Daxxn/EasyBakeOven/Docs/Pinouts/EasyBakeREV1Pinout.md

# EasyBakeREV1

> > Micro: **PRO-MICRO**
>
> > Digital Pins: **16**
> >
> > Analog Pins: **4**
>
> > Comms:
> > - SPI
> > - I2C
> > - UART

---

## Digital

### Oven
Pin Count: 3

| Pin | Name | Type
| --- | --- | --- |
| 6 | HTR_PWM | PWM |
| 4 | HTR_SW | IN |
| 2 | ESTOP | IN |

### Sensing
Pin Count: 1

| Pin | Name | Type
| --- | --- | --- |
| 6 | SW | IN |

### Indictors
Pin Count: 5

| Pin | Name | Type
| --- | --- | --- |
| 11 | COOL | PWM |
| 12 | STATUS | PWM |
| 36 | ERROR | OUT |
| 37 | ACT | OUT |
| 38 | HEAT | OUT |

### Display
Pin Count: 2

| Pin | Name | Type
| --- | --- | --- |
| 9 | BACKLIGHT | PWM |
| 13 | RESET | OUT |

## Analog

### Sensing
Pin Count: 2

| Pin | Name | Type
| --- | --- | --- |
| 4 | APEAK | IN |
| 5 | ACURRENT | IN |

## Serial

### SPI

### Pins

| Name | Pin |
| --- | --- |
| SCK | 15 |
| MISO | 14 |
| MOSI | 16 |

### Addresses

| Name | Pin |
| --- | --- |
| Display | 5 |
| IO | 4 |

### I2C

### Pins

| Name | Pin |
| --- | --- |
| SDA | 2 |
| SCL | 3 |

### UART

### Pins

| Name | Pin |
| --- | --- |
| TX | 1 |
| RX | 0 |

> Auto-generated by [PinGenerator app.](https://github.com/Daxxn/PinGenerator)
>
> Author: Daxxn
