Daxxn/EasyBakeOven/EasyBakeREV1/EasyBakePower.md

# Power Analysis

## 3.3V Rail Loads

| Ref | Device| Name | Current |
| --- | --- | --- | --- |
| A1 | ATMEGA32U4 | Arduino PRO-MICRO | 10mA |
| U5 | NHD-C12832A1Z | LCD Screen | 31mA |
| D-ACT | 0805-LED | LED - Activity Indicator | 15mA |
| D-ERR | 0805-LED | LED - Error Indicator | 15mA |
| D-HEAT | 0805-LED | LED - Heat Indicator | 15mA |
| D-COOL | 0805-LED | LED - Cool Indicator | 15mA |
| D-STA | 0805-LED | LED - Status Indicator | 15mA |
| D-PWR | 0805-LED | LED - Power Indicator | 15mA |
| D-USB | 0805-LED | LED - USB Status Indicator | 15mA |
| U7 | MAX31855 | Thermo Amp | 1.5mA |
| U8 | LMV324 | Current Amp | 1.2mA |
| SW-RST | TL3365 | Reset Switch | 330uA |
| SW-M-UP | TL3365 | Menu Up Switch | 330uA |
| SW-M-DN | TL3365 | Menu Down Switch | 330uA |
| SW-M-L | TL3365 | Menu Left Switch | 330uA |
| SW-M-R | TL3365 | Menu Right Switch | 330uA |
| SW-M-SEL | TL3365 | Menu Select Switch | 330uA |
| SW-M-BK | TL3365 | Menu Back Switch | 330uA |

### 3.3V Rail Total Load : 151mA
