Daxxn/EasyBakeOven/Docs/Schematics/EasyBake-REV1-SCH.pdf

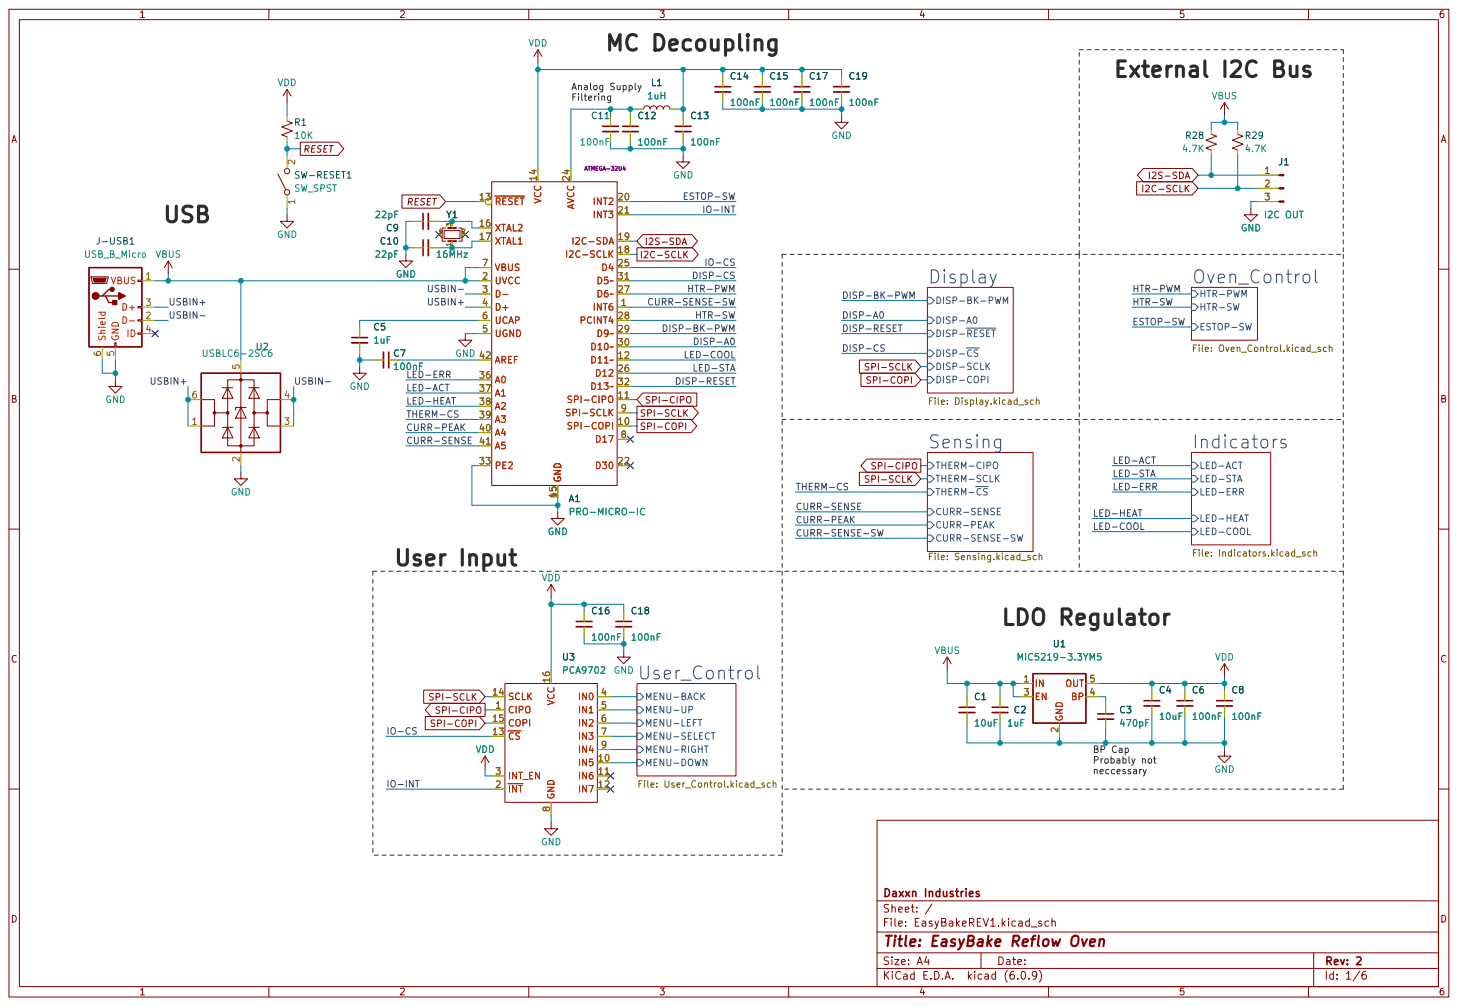
[picture p1: page 1]

IO-INT ESTOP-SW

File: Indicators.kicad_sch DISP-SCLK DISP-A0 DISP-~{CS} DISP-COPI DISP-~{RESET} DISP-BK-PWM Display

ESTOP-SW Oven_Control File: Oven_Control.kicad_sch CURR-PEAK

100nF GND

THERM-~{CS} CURR-SENSE CURR-SENSE-SW Sensing

Probably not neccessary User Input

File: EasyBakeREV1.kicad_sch Sheet: / Daxxn Industries MENU-BACK MENU-LEFT MENU-SELECT MENU-UP MENU-DOWN MENU-RIGHT User_Control File: User_Control.kicad_sch

SPI-COPI SPI-SCLK
SPI-CIPO

Id: 1/6 Title: EasyBake Reflow Oven

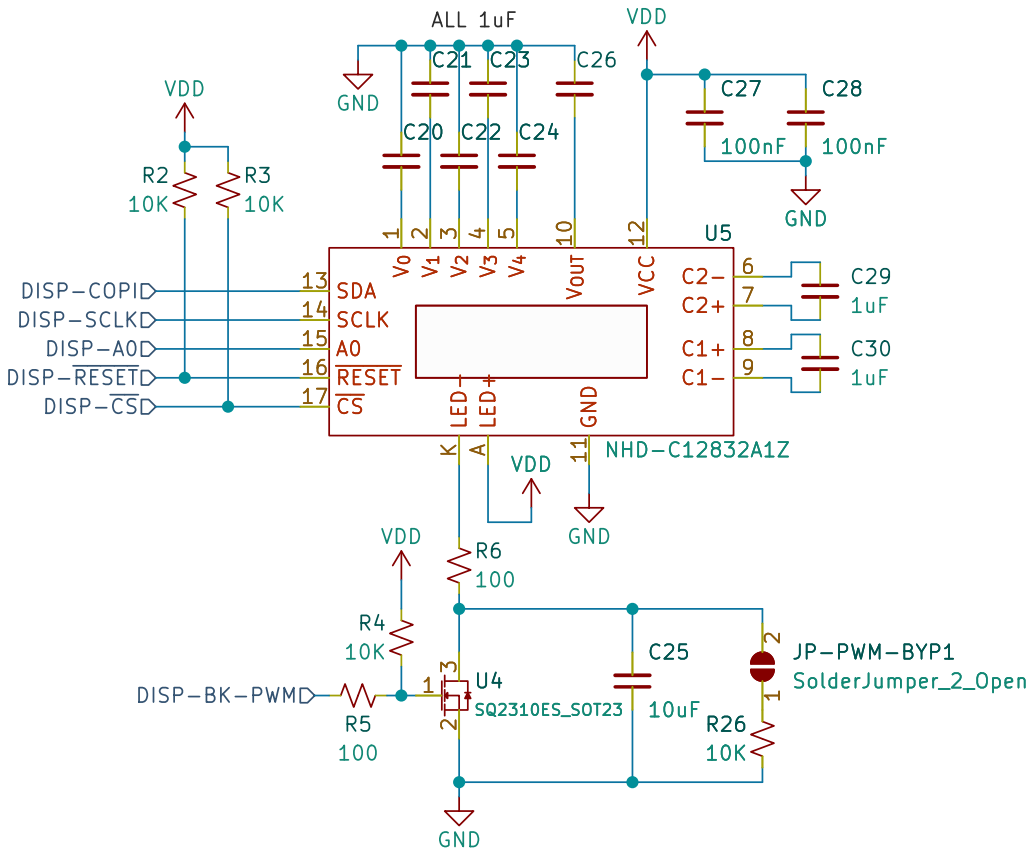
[picture p2: page 2]

10K DISP-COPI DISP-A0 DISP-~{RESET} DISP-BK-PWM

Sheet: /Display/ Daxxn Industries

File: Display.kicad_sch
Id: 2/6 Title: EasyBake Reflow Oven

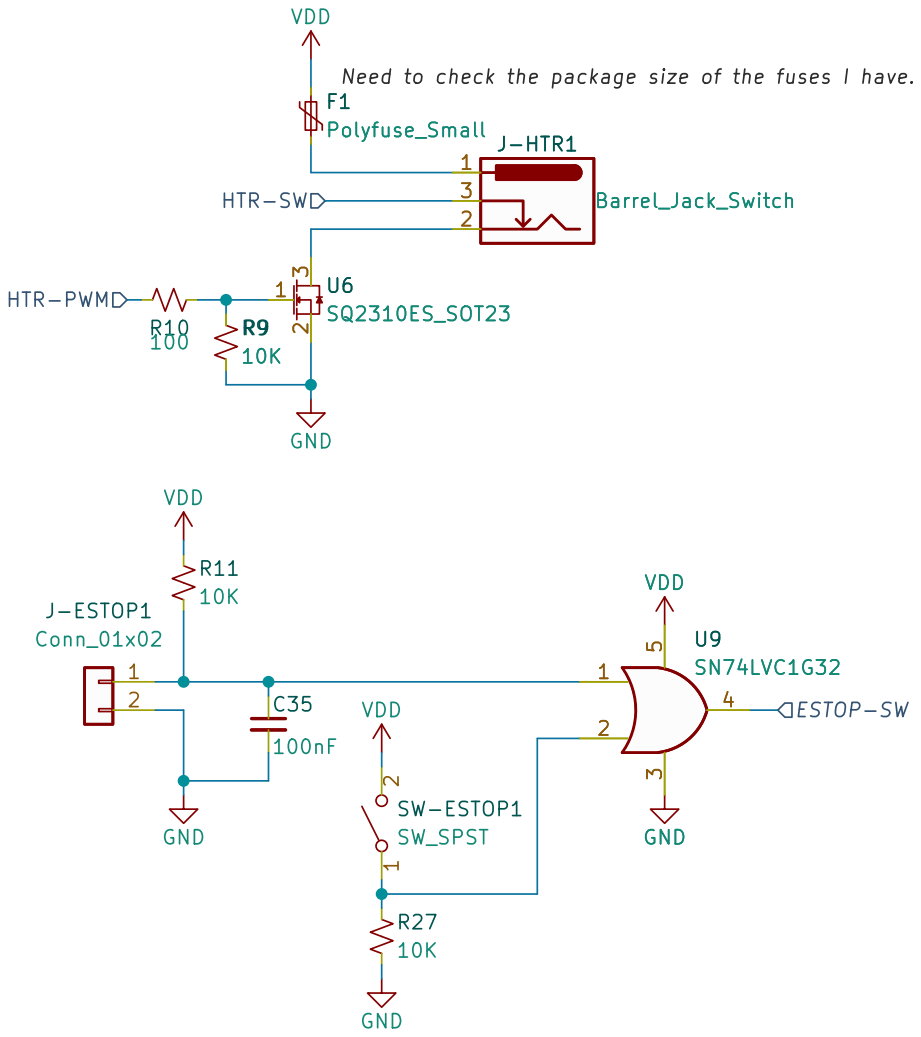
[picture p3: page 3]

Need to check the package size of the fuses I have. R9
10K GND GND

File: Oven_Control.kicad_sch
Id: 3/6 Title: EasyBake Reflow Oven

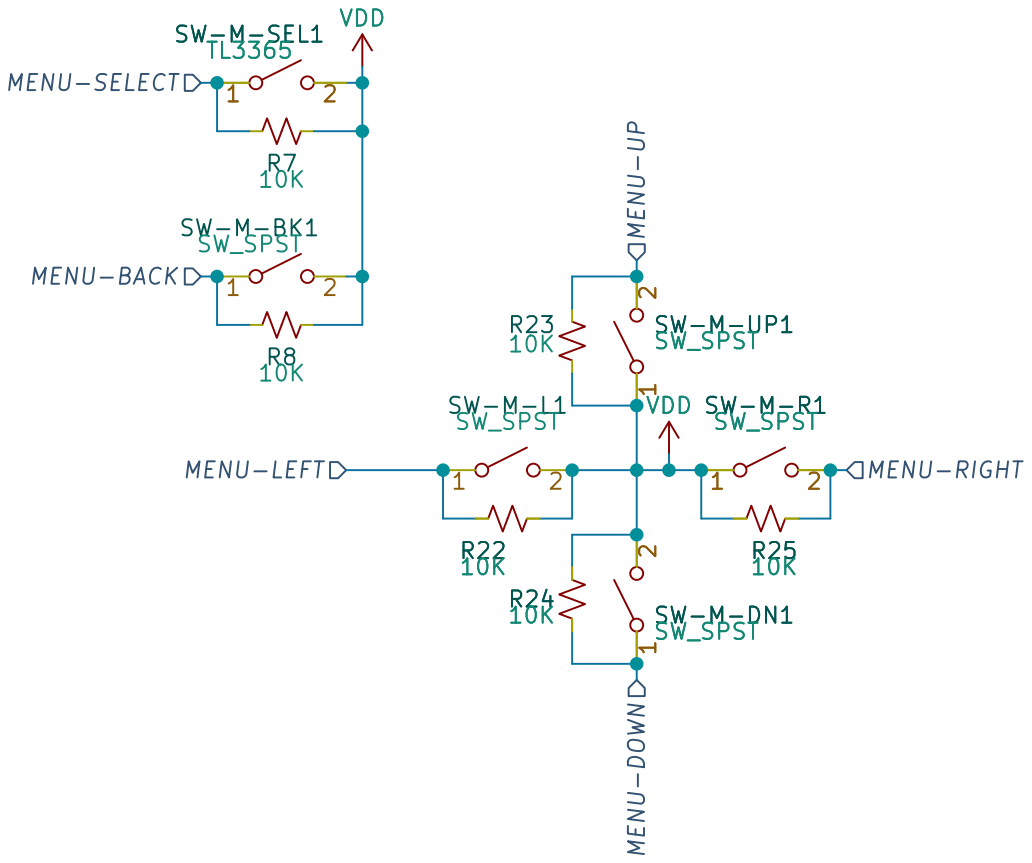
[picture p4: page 4]

1 2 SW-M-DN1 SW_SPST MENU-UP MENU-BACK MENU-LEFT MENU-SELECT MENU-RIGHT MENU-DOWN VDD

File: User_Control.kicad_sch
Id: 4/6 Title: EasyBake Reflow Oven

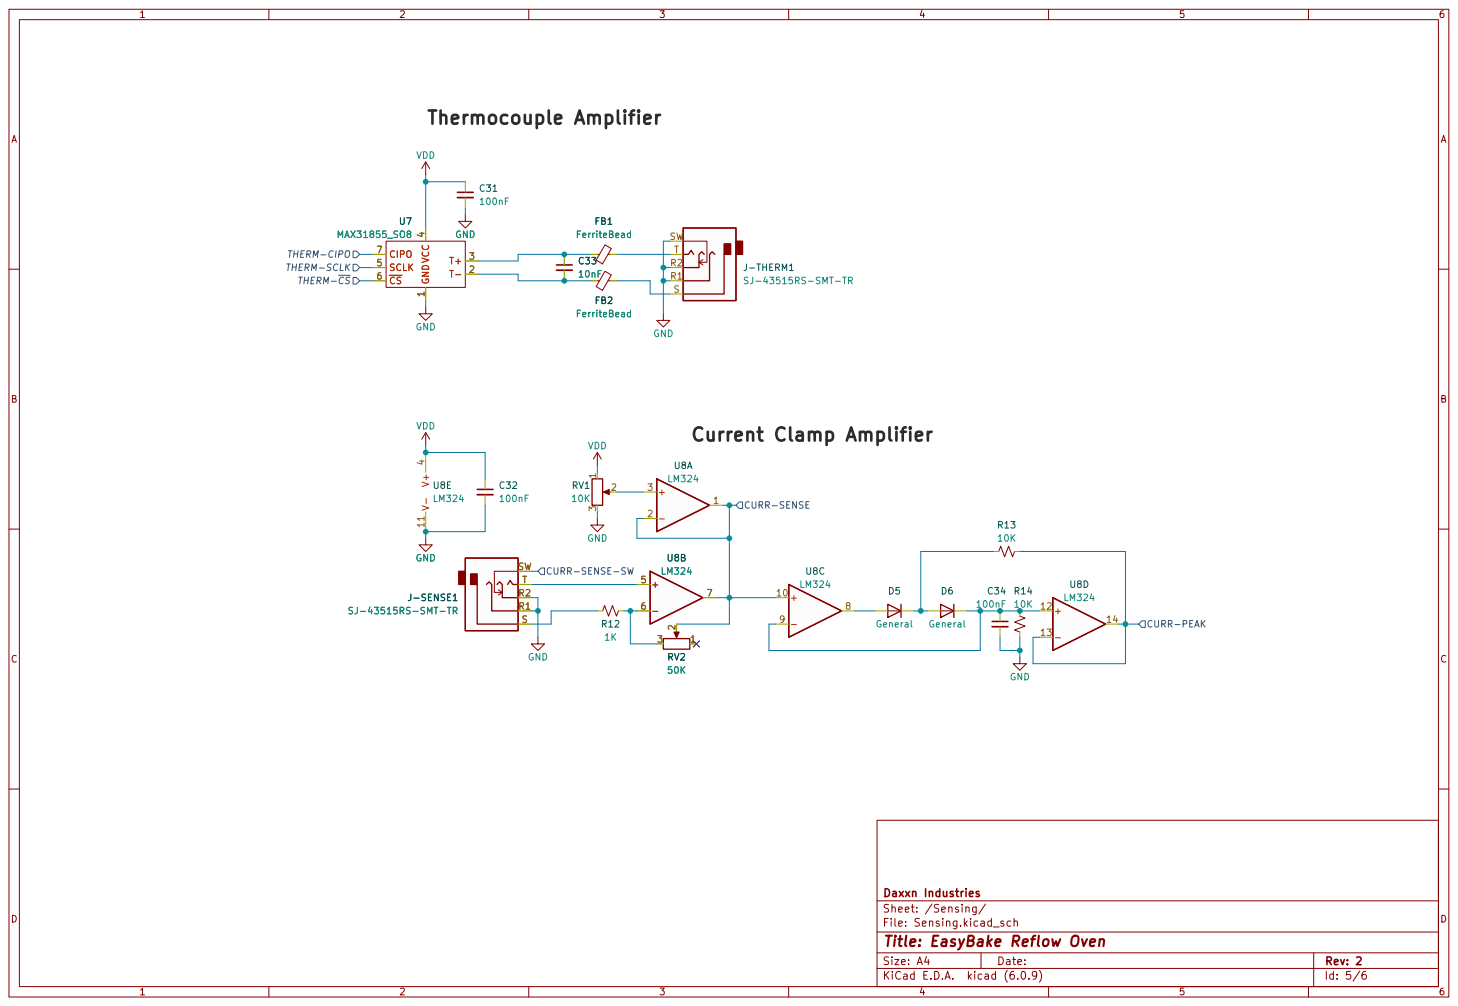
[picture p5: page 5]

CURR-SENSE Thermocouple Amplifier

4 SCLK 5 ~{CS} 6 CIPO 7 U7 MAX31855_SO8 VDD

File: Sensing.kicad_sch
Id: 5/6 Title: EasyBake Reflow Oven

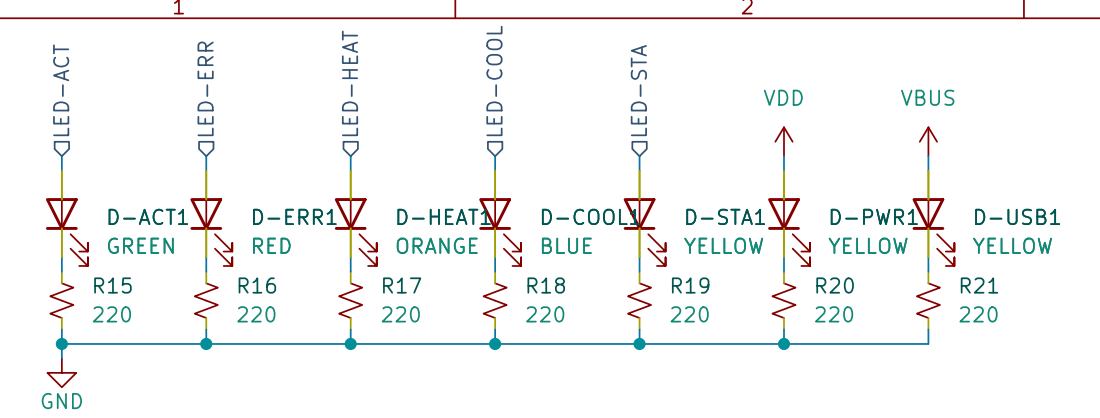
[picture p6: page 6]

File: Indicators.kicad_sch Sheet: /Indicators/
Id: 6/6 Title:
