Daxxn/EasyBakeOven/EasyBakeREV1/EasyBakeREV1.kicad_pcb

## KiCad design EasyBakeREV1/EasyBakeREV1.kicad_pcb (2023-03-19)

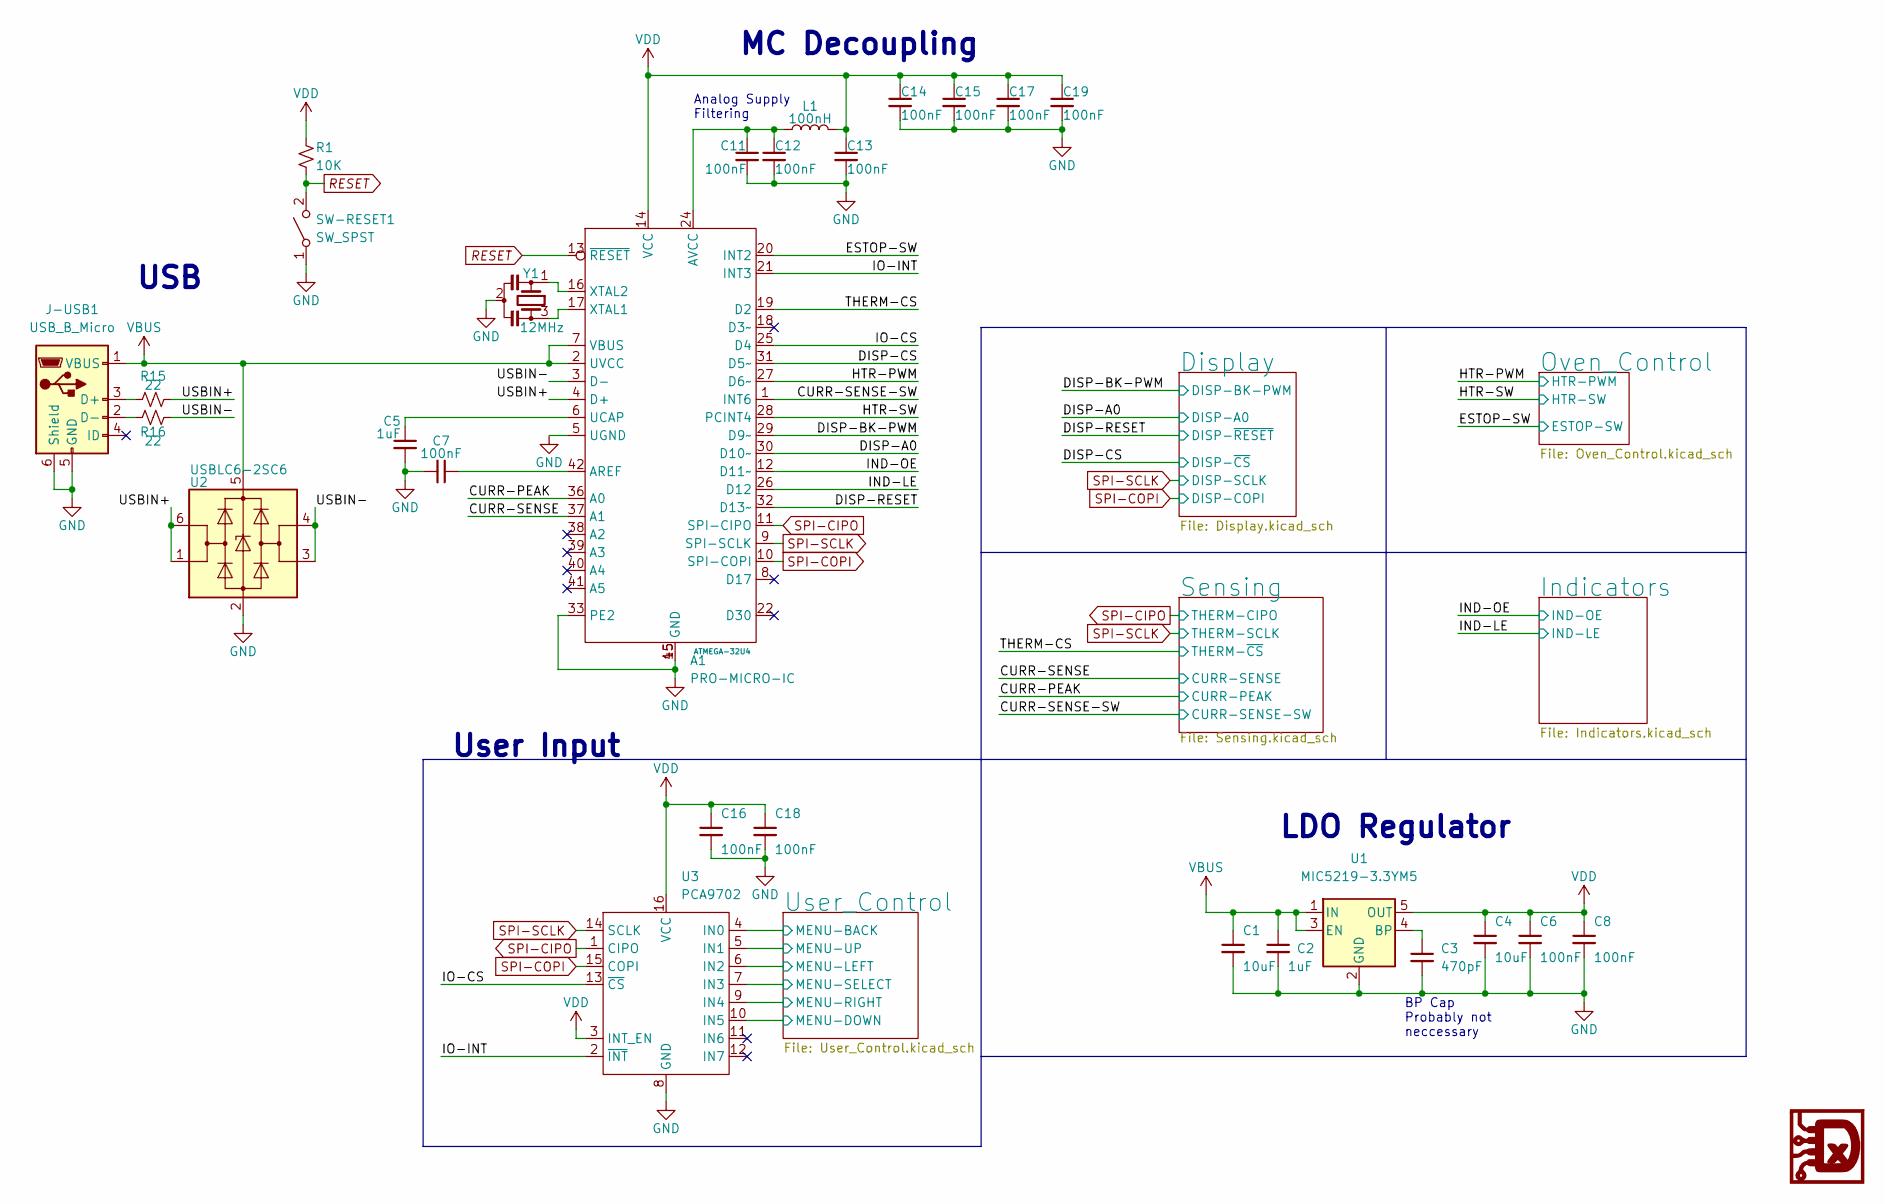
[picture p7: schematic EasyBakeREV1.kicad_sch, EasyBake Reflow Oven]

Parts:
A1: PRO-MICRO-IC; QFN-44-1EP_7x7mm_P0.5mm_EP4.8x4.8mm
C1, C4: 10uF; C_1210_3225Metric
C2: 1uF; C_1210_3225Metric
C3: 470pF; C_0603_1608Metric
C5: 1uF; C_0805_2012Metric
C6, C7, C8, C11, C12, C13, C14, C15, C16, C17, C18, C19: 100nF; C_0603_1608Metric
J-USB1: USB_B_Micro; USB-10103594
L1: 100nH; L_0603_1608Metric
R1: 10K; R_0603_1608Metric
R15, R16: 22; R_0402_1005Metric
SW-RESET1: SW_SPST; TL3365AF180QG
U1: MIC5219-3.3YM5; SOT-23-5
U2: USBLC6-2SC6; SOT-23-6
U3: PCA9702; SSOP-16_4.4x5.2mm_P0.65mm
Y1: 12MHz; Resonator_SMD_Murata_CSTxExxV-3Pin_3.0x1.1mm

Connections:
/CURR-PEAK: A1.36 (A0); also elsewhere on the board
/CURR-SENSE: A1.37 (A1); also elsewhere on the board
/CURR-SENSE-SW: A1.1 (INT6); also elsewhere on the board
/DISP-A0: A1.30 (D10~); also elsewhere on the board
/DISP-BK-PWM: A1.29 (D9~); also elsewhere on the board
/DISP-CS: A1.31 (D5~); also elsewhere on the board
/DISP-RESET: A1.32 (D13~); also elsewhere on the board
/ESTOP-SW: A1.20 (INT2); also elsewhere on the board
/HTR-PWM: A1.27 (D6~); also elsewhere on the board
/HTR-SW: A1.28 (PCINT4); also elsewhere on the board
/IND-LE: A1.26 (D12); also elsewhere on the board
/IND-OE: A1.12 (D11~); also elsewhere on the board
/IO-CS: A1.25 (D4), U3.13 (~CS)
/IO-INT: A1.21 (INT3), U3.2 (~INT)
/THERM-CS: A1.19 (D2); also elsewhere on the board
/USBIN+: A1.4 (D+), R15.2, U2.1 (I/O1), U2.6 (I/O1)
/USBIN-: A1.3 (D-), R16.2, U2.3 (I/O2), U2.4 (I/O2)
/User_Control/MENU-BACK: U3.4 (IN0); also elsewhere on the board
/User_Control/MENU-DOWN: U3.10 (IN5); also elsewhere on the board
/User_Control/MENU-LEFT: U3.6 (IN2); also elsewhere on the board
/User_Control/MENU-RIGHT: U3.9 (IN4); also elsewhere on the board
/User_Control/MENU-SELECT: U3.7 (IN3); also elsewhere on the board
/User_Control/MENU-UP: U3.5 (IN1); also elsewhere on the board
AVCC: A1.24 (AVCC), A1.44 (AVCC), C11.1, C12.1, L1.1
GND: A1.5 (UGND), A1.15 (GND), A1.23 (GND), A1.33 (PE2), A1.35 (GND), A1.43 (GND), A1.45 (GND), C1.2, C2.2, C3.2, C4.2, C5.2, C6.2, C7.2, C8.2, C11.2, C12.2, C13.2, C14.2, C15.2, C16.2, C17.2, C18.2, C19.2, J-USB1.5 (GND), J-USB1.6 (Shield), SW-RESET1.1 (A), U1.2 (GND), U2.2 (GND), U3.8 (GND), Y1.2; also elsewhere on the board
unnamed: A1.6 (UCAP), C5.1
unnamed: A1.16 (XTAL2), Y1.1
unnamed: A1.17 (XTAL1), Y1.3
unnamed: A1.42 (AREF), C7.1
unnamed: C3.1, U1.4 (BP)
unnamed: J-USB1.2 (D-), R16.1
unnamed: J-USB1.3 (D+), R15.1
RESET: A1.13 (~RESET), R1.2, SW-RESET1.2 (B)
SPI-CIPO: A1.11 (SPI-CIPO), U3.1 (CIPO); also elsewhere on the board
SPI-COPI: A1.10 (SPI-COPI), U3.15 (COPI); also elsewhere on the board
SPI-SCLK: A1.9 (SPI-SCLK), U3.14 (SCLK); also elsewhere on the board
VBUS: A1.2 (UVCC), A1.7 (VBUS), C1.1, C2.1, J-USB1.1 (VBUS), U1.1 (IN), U1.3 (EN), U2.5 (VBUS); also elsewhere on the board
VCC: A1.14 (VCC), A1.34 (VCC), C4.1, C6.1, C8.1, C13.1, C14.1, C15.1, C16.1, C17.1, C18.1, C19.1, L1.2, R1.1, U1.5 (OUT), U3.3 (INT_EN), U3.16 (VCC); also elsewhere on the board

Notes on the sheet:
LDO Regulator
Analog Supply Filtering
MC Decoupling
User Input
USB
BP Cap Probably not neccessary

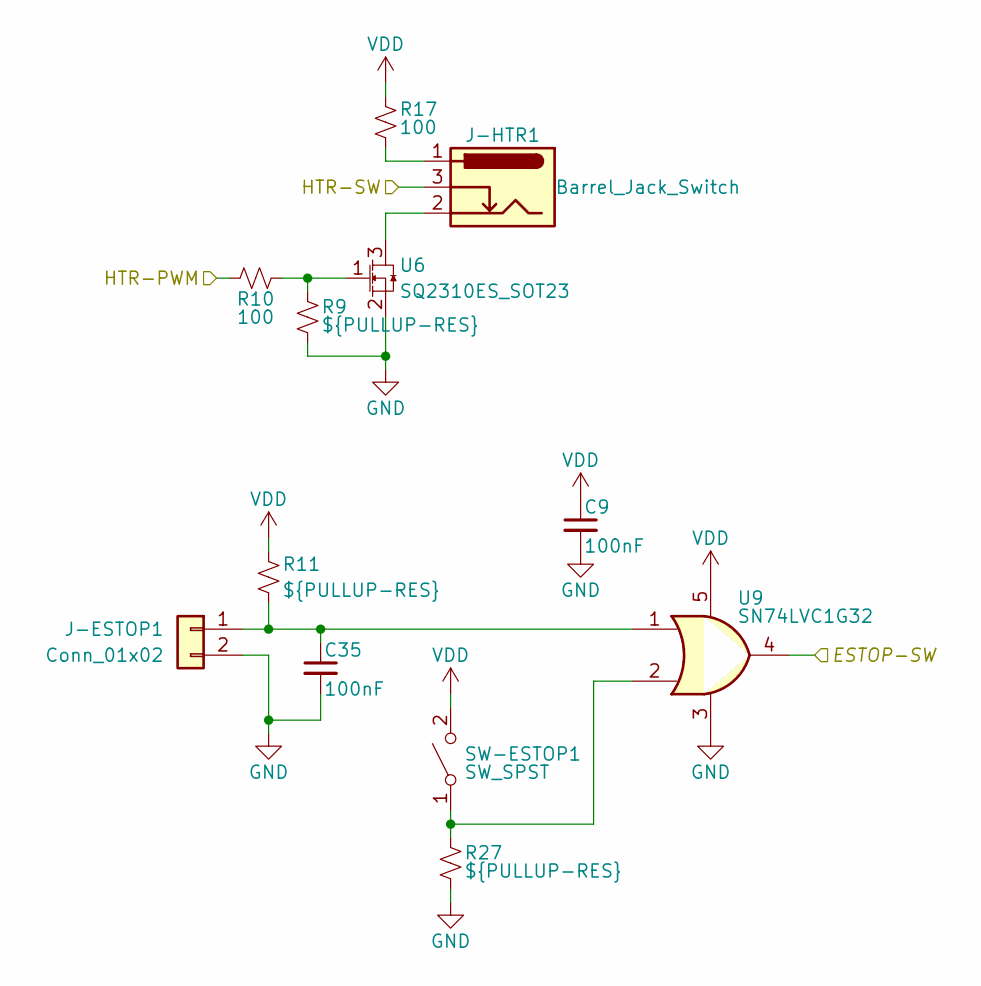
[picture p8: schematic Oven_Control.kicad_sch, EasyBake Reflow Oven]

Parts:
C9, C35: 100nF; C_0603_1608Metric
J-ESTOP1: Conn_01x02; JST_XH_B2B-XH-A_1x02_P2.50mm_Vertical
J-HTR1: Barrel_Jack_Switch; BarrelJack_Horizontal
R9, R11, R27: ${PULLUP-RES}; R_0603_1608Metric
R10, R17: 100; R_0603_1608Metric
SW-ESTOP1: SW_SPST; SW_PUSH_6mm_H8mm
U6: SQ2310ES_SOT23; SOT-23
U9: SN74LVC1G32; SOT-23-5

Connections:
/ESTOP-SW: U9.4; also elsewhere on the board
/HTR-PWM: R10.1; also elsewhere on the board
/HTR-SW: J-HTR1.3; also elsewhere on the board
GND: C9.2, C35.2, J-ESTOP1.2, R9.2, R27.1, U6.2 (S), U9.3; also elsewhere on the board
unnamed: C35.1, J-ESTOP1.1, R11.1, U9.1
unnamed: J-HTR1.1, R17.1
unnamed: J-HTR1.2, U6.3 (D)
unnamed: R9.1, R10.2, U6.1 (G)
unnamed: R27.2, SW-ESTOP1.1 (A), U9.2
VCC: C9.1, R11.2, R17.2, SW-ESTOP1.2 (B), U9.5; also elsewhere on the board

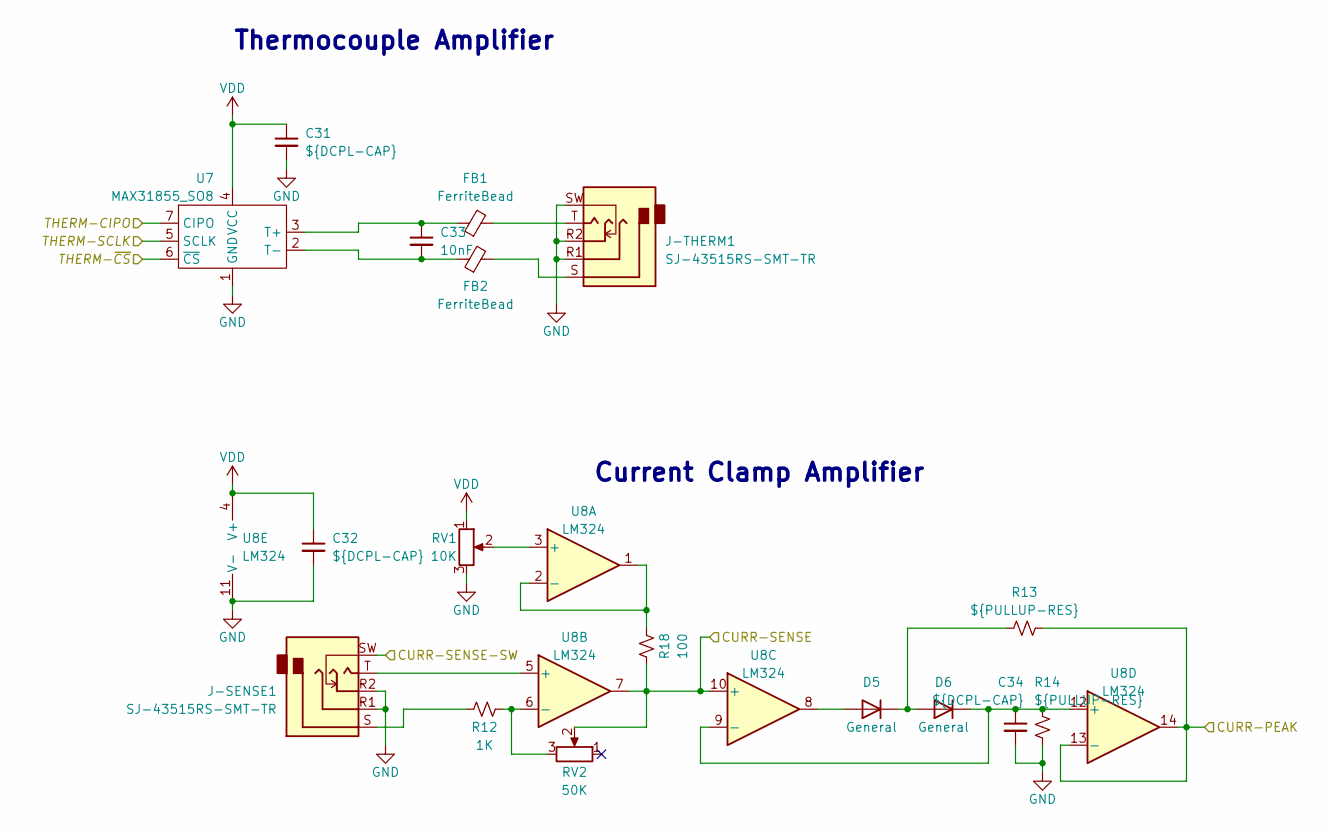
[picture p9: schematic Sensing.kicad_sch, EasyBake Reflow Oven]

Parts:
C31, C32, C34: ${DCPL-CAP}; C_0603_1608Metric
C33: 10nF; C_0603_1608Metric
D5, D6: General; D_SOD-323_HandSoldering
FB1, FB2: FerriteBead; L_1206_3216Metric
J-SENSE1: SJ-43515RS-SMT-TR
J-THERM1: SJ-43515RS-SMT-TR
R12: 1K; R_0603_1608Metric
R13, R14: ${PULLUP-RES}; R_0603_1608Metric
R18: 100; R_0603_1608Metric
RV1: 10K; Potentiometer_Bourns_3296W_Vertical
RV2: 50K; Potentiometer_Bourns_3296W_Vertical
U7: MAX31855_SO8; SO-8_3.9x4.9mm_P1.27mm
U8: LM324; TSSOP-14_4.4x5mm_P0.65mm

Connections:
/CURR-PEAK: R13.2, U8.13 (-), U8.14; also elsewhere on the board
/CURR-SENSE: R18.1, RV2.2, U8.7, U8.10 (+); also elsewhere on the board
/CURR-SENSE-SW: J-SENSE1.SW; also elsewhere on the board
/THERM-CS: U7.6 (~CS); also elsewhere on the board
GND: C31.2, C32.2, C34.2, J-SENSE1.R1, J-SENSE1.R2, J-THERM1.R1, J-THERM1.R2, J-THERM1.SW, R14.1, RV1.3, U7.1 (GND), U8.11 (V-); also elsewhere on the board
unnamed: C33.1, FB1.1, U7.3 (T+)
unnamed: C33.2, FB2.1, U7.2 (T-)
unnamed: C34.1, D6.1 (K), R14.2, U8.9 (-), U8.12 (+)
unnamed: D5.1 (K), D6.2 (A), R13.1
unnamed: D5.2 (A), U8.8
unnamed: FB1.2, J-THERM1.T
unnamed: FB2.2, J-THERM1.S
unnamed: J-SENSE1.S, R12.1
unnamed: J-SENSE1.T, U8.5 (+)
unnamed: R12.2, RV2.3, U8.6 (-)
unnamed: R18.2, U8.1, U8.2 (-)
unnamed: RV1.2, U8.3 (+)
SPI-CIPO: U7.7 (CIPO); also elsewhere on the board
SPI-SCLK: U7.5 (SCLK); also elsewhere on the board
VCC: C31.1, C32.1, RV1.1, U7.4 (VCC), U8.4 (V+); also elsewhere on the board

Notes on the sheet:
Thermocouple Amplifier
Current Clamp Amplifier

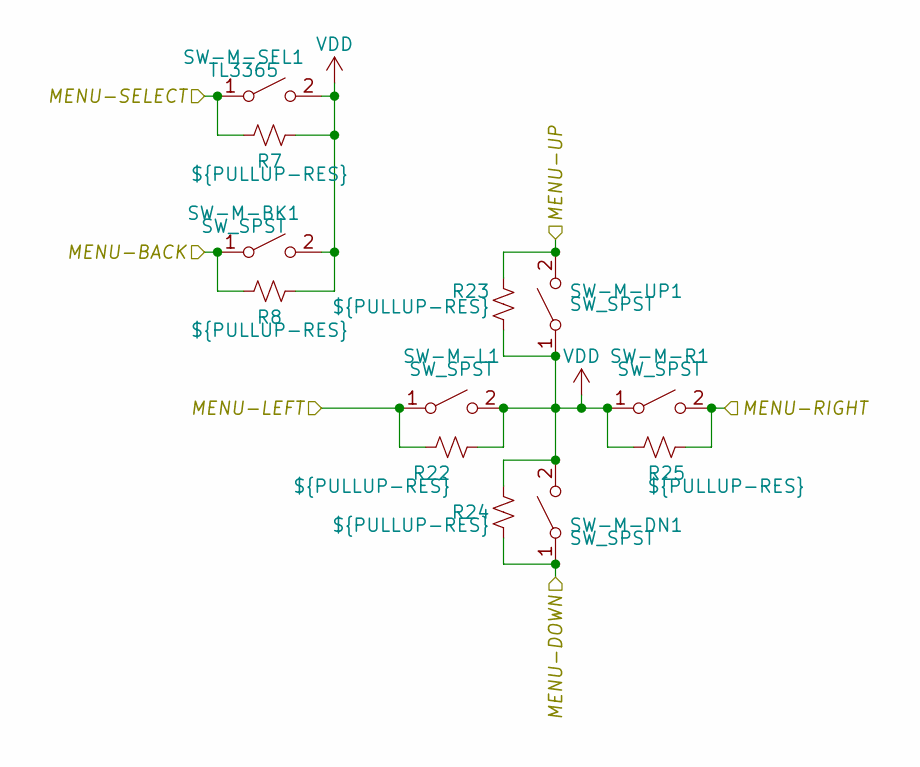
[picture p10: schematic User_Control.kicad_sch, EasyBake Reflow Oven]

Parts:
R7, R8, R22, R23, R24, R25: ${PULLUP-RES}; R_0805_2012Metric
SW-M-BK1: SW_SPST; TL3365AF180QG
SW-M-DN1: SW_SPST; TL3365AF180QG
SW-M-L1: SW_SPST; TL3365AF180QG
SW-M-R1: SW_SPST; TL3365AF180QG
SW-M-SEL1: TL3365; TL3365AF180QG
SW-M-UP1: SW_SPST; TL3365AF180QG

Connections:
/User_Control/MENU-BACK: R8.1, SW-M-BK1.1 (A); also elsewhere on the board
/User_Control/MENU-DOWN: R24.2, SW-M-DN1.1 (A); also elsewhere on the board
/User_Control/MENU-LEFT: R22.1, SW-M-L1.1 (A); also elsewhere on the board
/User_Control/MENU-RIGHT: R25.2, SW-M-R1.2 (B); also elsewhere on the board
/User_Control/MENU-SELECT: R7.1, SW-M-SEL1.1 (A); also elsewhere on the board
/User_Control/MENU-UP: R23.1, SW-M-UP1.2 (B); also elsewhere on the board
VCC: R7.2, R8.2, R22.2, R23.2, R24.1, R25.1, SW-M-BK1.2 (B), SW-M-DN1.2 (B), SW-M-L1.2 (B), SW-M-R1.1 (A), SW-M-SEL1.2 (B), SW-M-UP1.1 (A); also elsewhere on the board

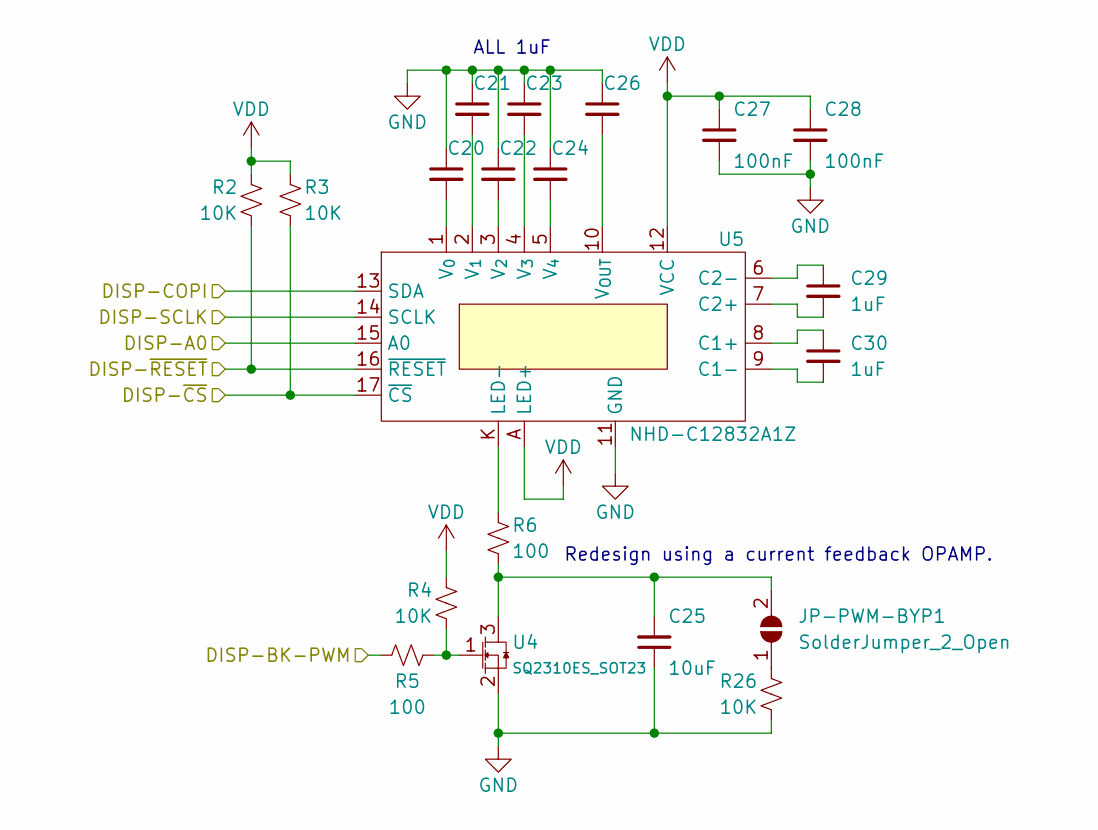
[picture p11: schematic Display.kicad_sch, EasyBake Reflow Oven]

Parts:
C20, C21, C22, C23, C24, C26, C29, C30: 1uF; C_1210_3225Metric
C25: 10uF; C_0805_2012Metric
C27, C28: 100nF; C_0805_2012Metric
JP-PWM-BYP1: SolderJumper_2_Open; SolderJumper-2_P1.3mm_Open_TrianglePad1.0x1.5mm
R2, R3, R4, R26: 10K; R_0603_1608Metric
R5, R6: 100; R_0603_1608Metric
U4: SQ2310ES_SOT23; SOT-23
U5: NHD-C12832A1Z

Connections:
/DISP-A0: U5.15 (A0); also elsewhere on the board
/DISP-BK-PWM: R5.2; also elsewhere on the board
/DISP-CS: R3.2, U5.17 (~CS); also elsewhere on the board
/DISP-RESET: R2.2, U5.16 (~RESET); also elsewhere on the board
GND: C20.1, C21.1, C22.1, C23.1, C24.1, C25.1, C26.1, C27.2, C28.2, R26.2, U4.2 (S), U5.11 (GND); also elsewhere on the board
unnamed: C20.2, U5.1 (V_{0})
unnamed: C21.2, U5.2 (V_{1})
unnamed: C22.2, U5.3 (V_{2})
unnamed: C23.2, U5.4 (V_{3})
unnamed: C24.2, U5.5 (V_{4})
unnamed: C25.2, JP-PWM-BYP1.2 (B), R6.2, U4.3 (D)
unnamed: C26.2, U5.10 (V_{OUT})
unnamed: C29.1, U5.6 (C2-)
unnamed: C29.2, U5.7 (C2+)
unnamed: C30.1, U5.8 (C1+)
unnamed: C30.2, U5.9 (C1-)
unnamed: JP-PWM-BYP1.1 (A), R26.1
unnamed: R4.2, R5.1, U4.1 (G)
unnamed: R6.1, U5.K (LED-)
SPI-COPI: U5.13 (SDA); also elsewhere on the board
SPI-SCLK: U5.14 (SCLK); also elsewhere on the board
VCC: C27.1, C28.1, R2.1, R3.1, R4.1, U5.12 (VCC), U5.A (LED+); also elsewhere on the board

Notes on the sheet:
ALL 1uF
Redesign using a current feedback OPAMP.

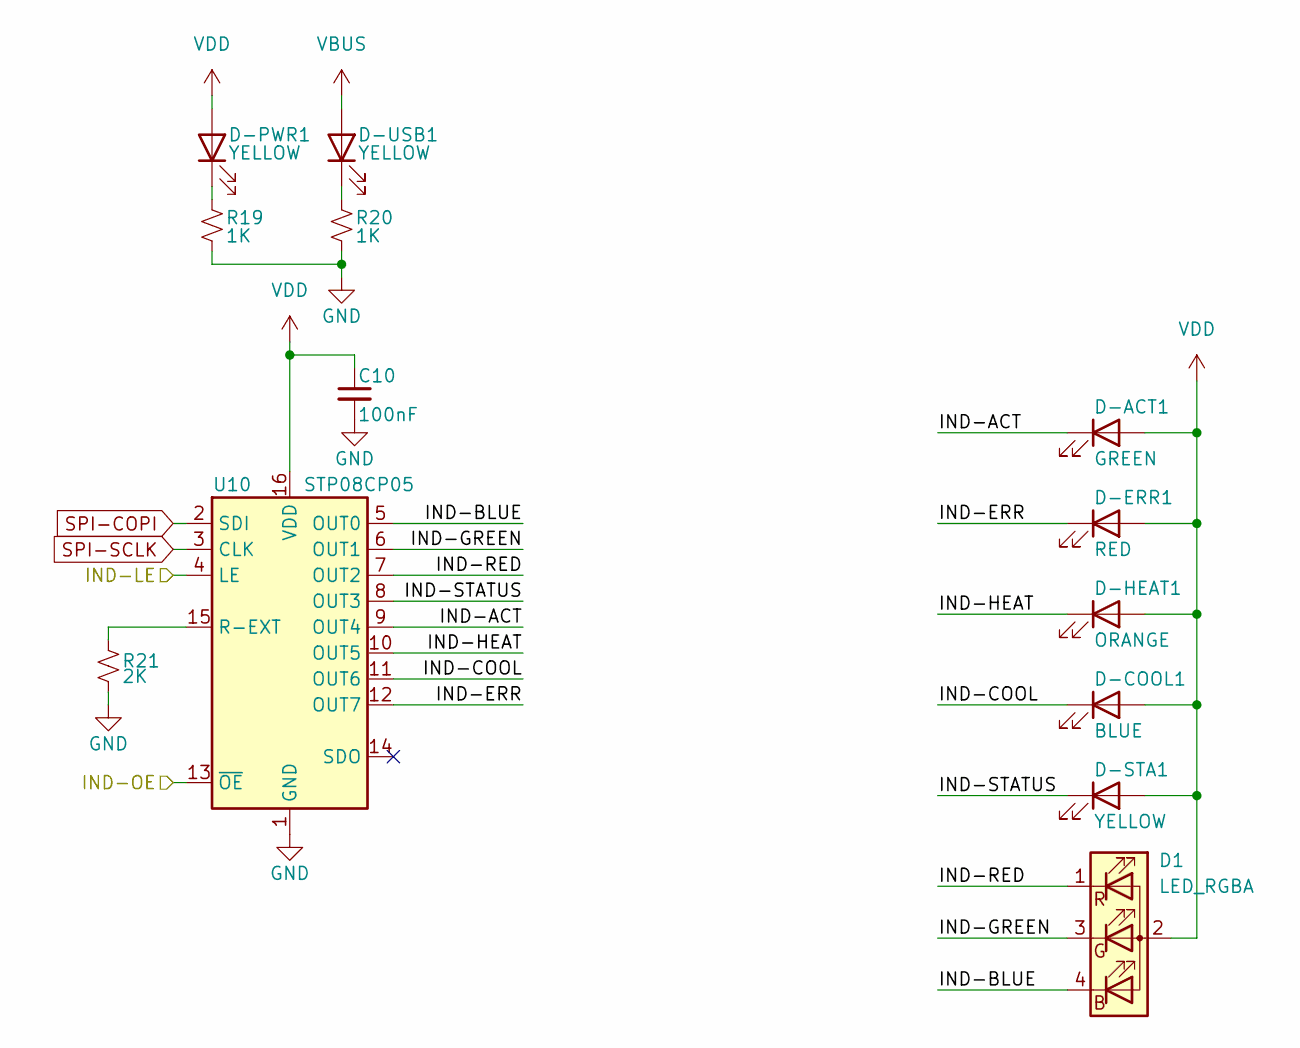
[picture p12: schematic Indicators.kicad_sch, EasyBake Reflow Oven]

Parts:
C10: 100nF; C_0603_1608Metric
D1: LED_RGBA; IN-P32TATRGB
D-ACT1: GREEN; LED_0805_2012Metric_Pad1.15x1.40mm_HandSolder
D-COOL1: BLUE; LED_0805_2012Metric_Pad1.15x1.40mm_HandSolder
D-ERR1: RED; LED_0805_2012Metric_Pad1.15x1.40mm_HandSolder
D-HEAT1: ORANGE; LED_0805_2012Metric_Pad1.15x1.40mm_HandSolder
D-PWR1: YELLOW; LED_0805_2012Metric_Pad1.15x1.40mm_HandSolder
D-STA1: YELLOW; LED_0805_2012Metric_Pad1.15x1.40mm_HandSolder
D-USB1: YELLOW; LED_0805_2012Metric_Pad1.15x1.40mm_HandSolder
R19, R20: 1K; R_0805_2012Metric
R21: 2K; R_0805_2012Metric
U10: STP08CP05; TSSOP-16-1EP_4.4x5mm_P0.65mm_EP3x3mm

Connections:
/IND-LE: U10.4 (LE); also elsewhere on the board
/IND-OE: U10.13 (~OE); also elsewhere on the board
/Indicators/IND-ACT: D-ACT1.1 (K), U10.9 (OUT4)
/Indicators/IND-BLUE: D1.4 (A), U10.5 (OUT0)
/Indicators/IND-COOL: D-COOL1.1 (K), U10.11 (OUT6)
/Indicators/IND-ERR: D-ERR1.1 (K), U10.12 (OUT7)
/Indicators/IND-GREEN: D1.3 (BK), U10.6 (OUT1)
/Indicators/IND-HEAT: D-HEAT1.1 (K), U10.10 (OUT5)
/Indicators/IND-RED: D1.1 (RK), U10.7 (OUT2)
/Indicators/IND-STATUS: D-STA1.1 (K), U10.8 (OUT3)
GND: C10.2, R19.2, R20.2, R21.2, U10.1 (GND); also elsewhere on the board
unnamed: D-PWR1.1 (K), R19.1
unnamed: D-USB1.1 (K), R20.1
unnamed: R21.1, U10.15 (R-EXT)
SPI-COPI: U10.2 (SDI); also elsewhere on the board
SPI-SCLK: U10.3 (CLK); also elsewhere on the board
VBUS: D-USB1.2 (A); also elsewhere on the board
VCC: C10.1, D1.2 (GK), D-ACT1.2 (A), D-COOL1.2 (A), D-ERR1.2 (A), D-HEAT1.2 (A), D-PWR1.2 (A), D-STA1.2 (A), U10.16 (VDD); also elsewhere on the board

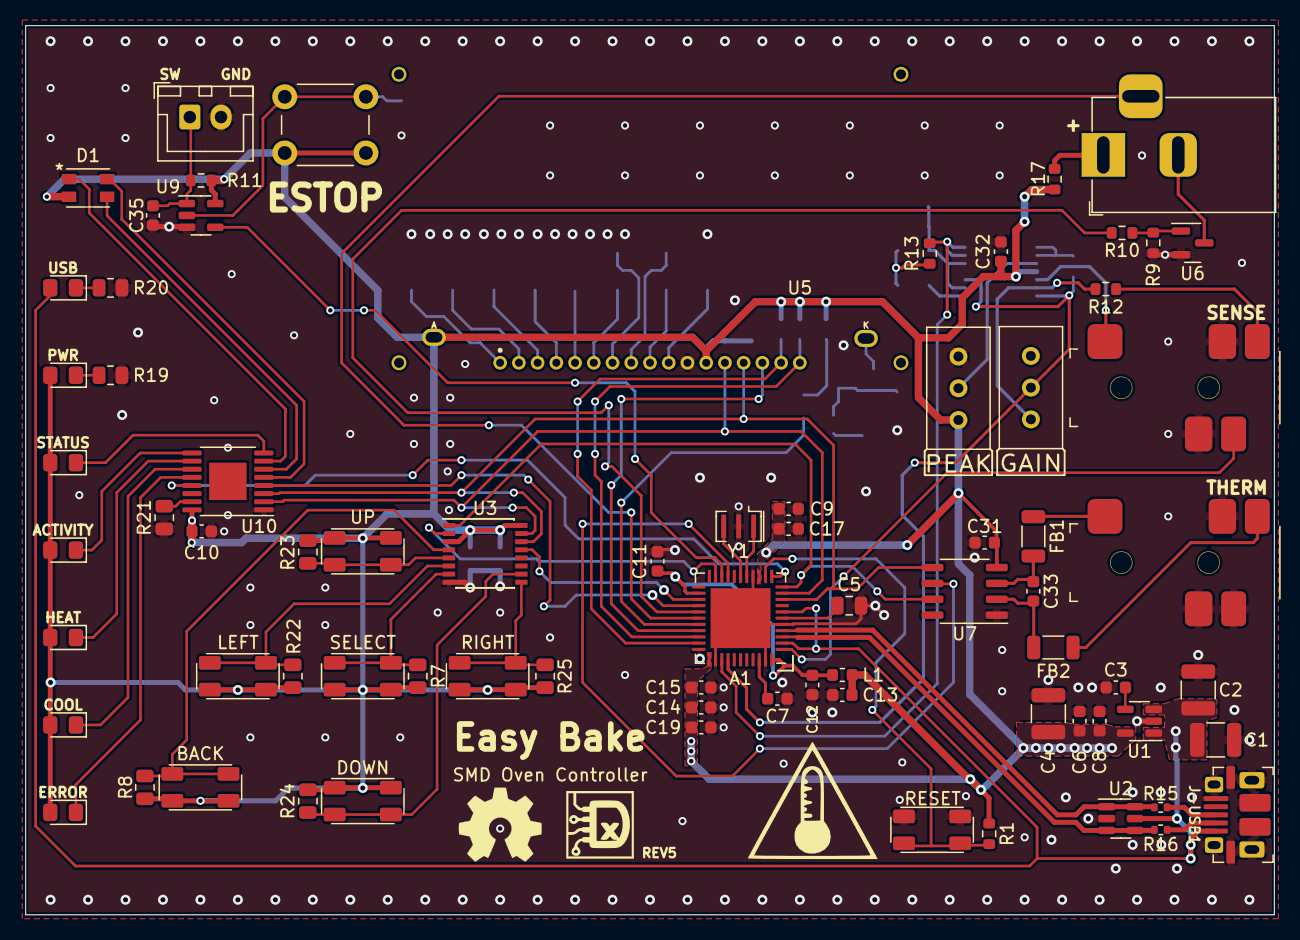
[picture p13: board EasyBakeREV1.kicad_pcb from above]

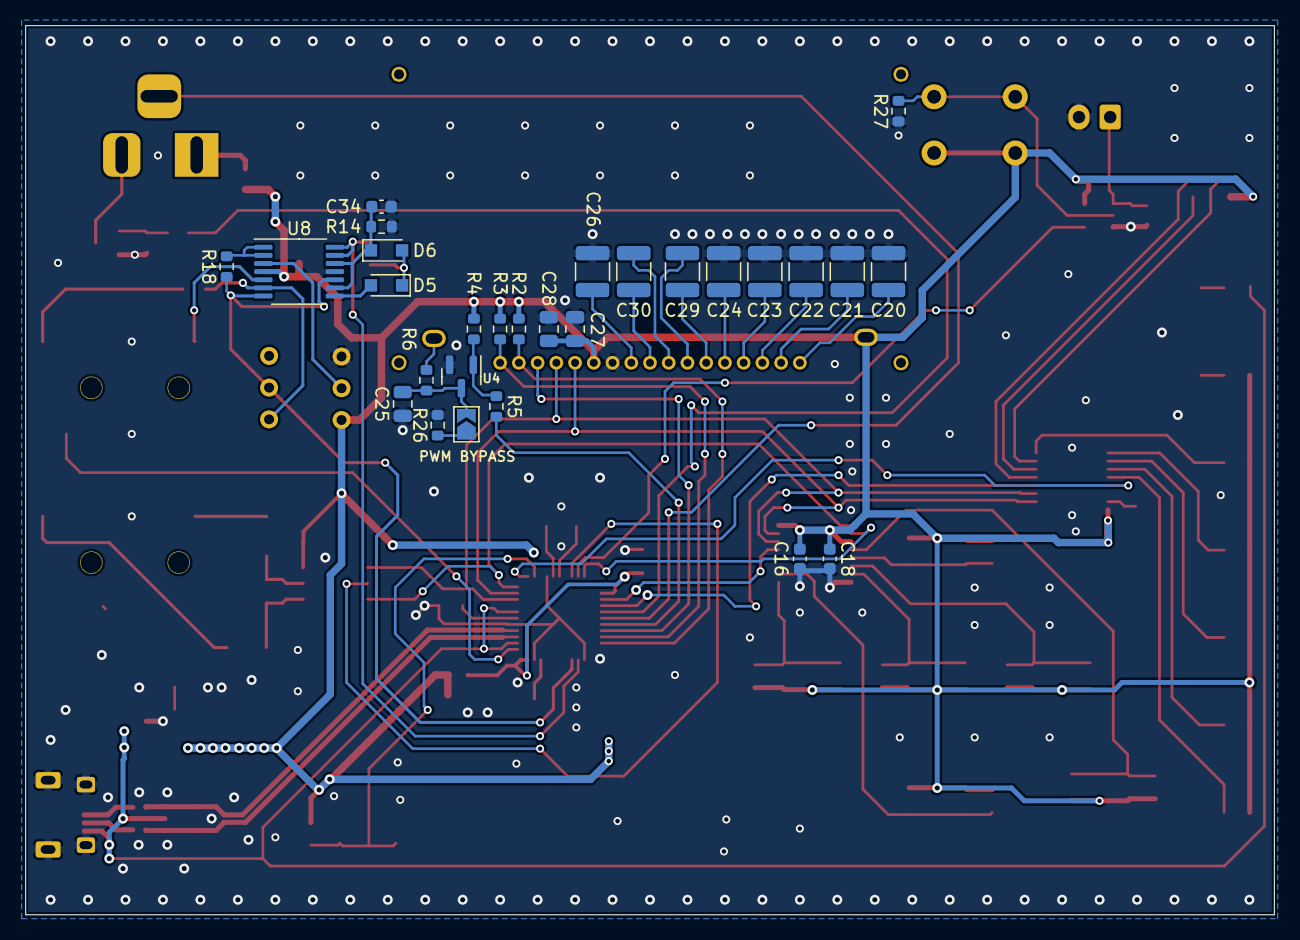
[picture p14: board EasyBakeREV1.kicad_pcb from below]

Board: 2 copper layers, 100.0 x 71.2 mm, 103 parts (28 on the bottom side), 80 nets.
