Daxxn/EasyBakeOven/(commit log)

2023-01-13 REV3 - Reorganize MC pinouts and add LED driver (WIP)
    [Display.kicad_sch, EasyBakeREV1.kicad_pcb, EasyBakeREV1.kicad_sch, Indicators.kicad_sch, Oven_Control.kicad_sch, Sensing.kicad_sch]
2023-03-19 Update to KiCad 7
    [Display.kicad_sch, EasyBakeREV1.kicad_pcb, EasyBakeREV1.kicad_sch, Indicators.kicad_sch, Oven_Control.kicad_sch, Sensing.kicad_sch, User_Control.kicad_sch]
